UCSD-Silberman-Classes-and-Projects/UCSD-ECE180-SUMMER_I-Final_Project-Team_4/proposal/slides.pdf

# MouseBot: Edge AI Evasion Robot

A vision-guided robot car that flees a pursuing person Arduino UNO Q · ECE 180 · Final Project Proposal

## Team #4

Charlie Kushelevsky | Math + Electrical & Computer Engineering
Jaafar Sameer | Electrical & Computer Engineering
Ryan Chen | Electrical & Computer Engineering

## What We Are Proposing

An autonomous robot car (ELEGOO chassis, re-controlled by the Arduino UNO Q) that uses its camera to detect a pursuing person and drive away to avoid being caught — while steering clear of walls and obstacles. All perception and decision-making run on-device, no cloud. Where the AI/ML runs (on the AUQ):
h

A TFLite person-detection CNN executes on the UNO Q Ubuntu MPU, producing the pursuer’s bearing and proximity from each camera frame.
An on-device evasion policy converts detections (fused with an ultrasonic range sensor) into escape headings, sent to the STM32 for real-time motor control.

Must haves
On-device person detection on the MPU
Bearing + proximity estimation
Reactive escape steering (flee the pursuer) Ultrasonic wall/obstacle avoidance on STM32
Measurable “time-to-capture” metric

Nice to haves
Corner-aware evasion (avoid self-trapping) Learned evasion policy (RL in sim → transfer)
Multi-pursuer / target re-identification
UC San Diego | JSOE | ECE 180 | Team #4 | 2/3 Live FPV / detection overlay stream

## Project Plan — Gantt Chart (Week 2 → Week 5)

Week 2 | Week 3 | Week 4 | Week 5

### 1. Platform & Perception

Board bring-up + chassis pin mapping

USB camera capture on MPU

Person-detection CNN (TFLite, on-device)

### 2. Control & Evasion

Motor + ultrasonic loop on STM32

Bearing/proximity + escape policy

Obstacle-aware evasion tuning

### 3. Integration & Delivery

End-to-end MPU↔STM32 integration

Time-to-capture testing + tuning

Documentation + final demo

Due

UC San Diego | JSOE | ECE 180 | Team #4 | 3/3
