UCSD-Silberman-Classes-and-Projects/UCSD-ECE180-SUMMER_I-Final_Project-Team_4/assets/finalmousebot.png

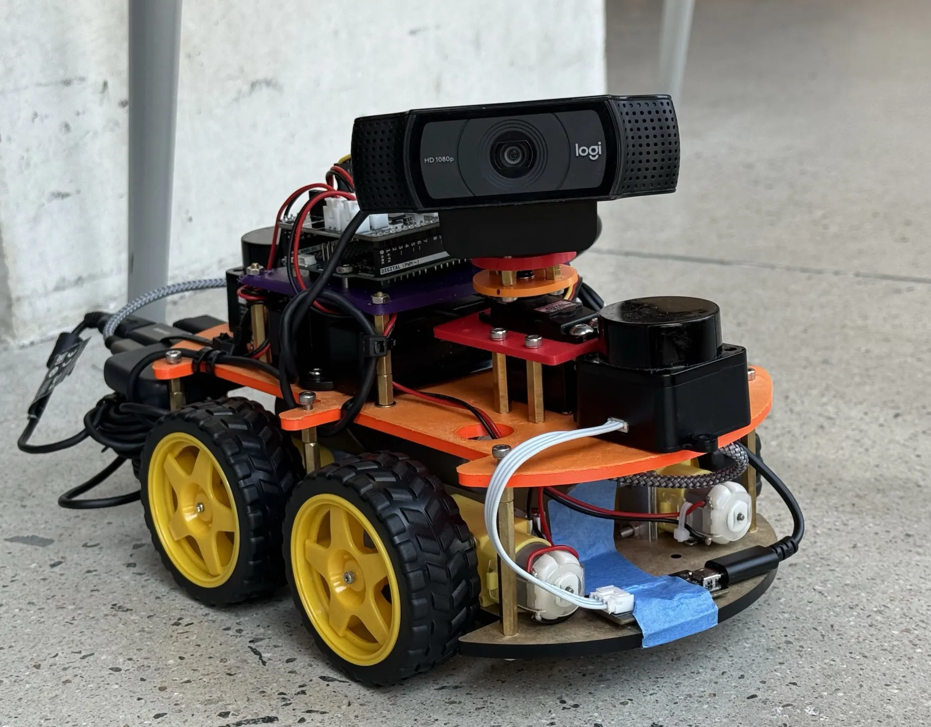
assets/finalmousebot.png
