UCSD-Silberman-Classes-and-Projects/UCSD-ECE180-SUMMER_I-Final_Project-Team_4/scripts/collect_frames.py

"""Save camera frames to disk for debugging and offline detector testing.

    python -m scripts.collect_frames --out data/frames --count 100 --interval 0.2
"""

import argparse
import os
import time

import cv2

from app.perception.camera import Camera, parse_source


def main():
    ap = argparse.ArgumentParser()
    ap.add_argument("--out", default="data/frames")
    ap.add_argument("--count", type=int, default=100)
    ap.add_argument("--interval", type=float, default=0.2)
    ap.add_argument("--camera", default=None,
                    help="V4L2 index (e.g. 0) or stream URL; "
                         "defaults to config.CAMERA_SOURCE")
    args = ap.parse_args()

    os.makedirs(args.out, exist_ok=True)
    camera = Camera(parse_source(args.camera))

    saved = 0
    while saved < args.count:
        frame = camera.read()
        if frame is None:
            continue
        path = os.path.join(args.out, f"frame_{saved:04d}.jpg")
        cv2.imwrite(path, frame)
        saved += 1
        time.sleep(args.interval)

    camera.release()
    print(f"saved {saved} frames to {args.out}")


if __name__ == "__main__":
    main()
