UCSD-Silberman-Classes-and-Projects/UCSD-ECE180-SUMMER_I-Final_Project-Team_4/(commit log)

2026-08-02 Enhance README with top deck plate modifications
    Added detailed information about the modifications and future plans for the top deck plate, including standoff usage and potential camera placements.
2026-08-02 Refactor section headings to title case
    Updated section headings in README.md to use title case for consistency.
